loggerhead-instruments/HS1-HS2/Altium/PCBWAY_BOM/LS1-LS2-v3_bom.xlsx

Comment | Description | DigiKey | Designator | Footprint | Quantity | Notes
10uF | TCP0J106M8R | https://www.digikey.com/en/products/detail/rohm-semiconductor/TCP0J106M8R/923644 | C1, C3, C8, C13, C19 | Tant0805 | 5
0.1uF | Ceramic Chip Capacitor - X7R, 10% |  | C2, C5, C7, C9, C12, C14, C16, C18, C20 | 0402 | 9
1uF | Ceramic Chip Capacitor - X7R, 1% |  | C4, C10, C15, C21, C23, C24, C25, C26, C27, C28 | 0402 | 10
0.01uF | Ceramic Chip Capacitor - X7R, 10% |  | C6, C11, C17, C22 | 0402 | 4
switch | E-Switch EG1218 Slide Switch 200mA 30V | EG1903-ND | P2 | HDR1X3 | 1
C-GRID | 705530036 | WM4924-ND | P3 | HDR1X2 | 5
microSD Hirose | DM3D-SF | HR1941CT-ND | P4 | DM3D microSD | 1
pushbutton | FSM2JSMATR | 450-1757-2-ND | P13, P14, P15 | SOP4 | 3
C-GRID | 705530037 | WM4925-ND | P16, P17 | HDR1X3 | 2
CoinCellHolder | BU2032SM-BT-GTR |  | P24 | CoinCellHolder | 1
100k | ERJ-3EKF1003V 100k 1% 0603 |  | R1, R2 | 3-0603 | 2
10k | ERJ-3EKF1002V 10k 1% 0603 |  | R8, R9, R10 | 3-0603 | 3
4.7k | ERJ-3EKF4701V 1% 0603 |  | R4, R5 | 3-0603 | 2
TPS7A2033PDBVR | 300-mA, ultra-low-noise, low-IQ, low-dropout (LDO) linear regulator with high PSRR |  | U1 | MF05A_N (SOT-23) | 1
LP3985IM5-3.3 | Micropower, 150mA Low-Noise Ultra Low-Dropout CMOS Voltage Regulator | LP3985IM5-3.3/NOPBTR-ND | U2, U4, U5 | MF05A_N (SOT-23) | 3
SGTL5000 | SGTL5000XNAA3R2 | SGTL5000XNAA3R2CT-ND | U3 | QFN32 | 1
TLV70018DCKR | Single Output LDO, 200 mA, Fixed 1.8 V Output, 2 to 5.5 V Input, with Low IQ, 5-pin SC70 (DCK), -40 to 125 degC, Green (RoHS & no Sb/Br) | 296-32409-1-ND | U6 | TI-DCK5_V | 1
DS3231 | DS3231 Real-time clock | https://www.digikey.com/en/products/detail/maxim-integrated/DS3231S-T-R/1197575 | U10 | DS3231 | 1
Do not place the following
T495X227K010ATE050 | Solid Tantalum Chip Capacitor, Standard T495 Series - Low ESR, Surge Robust |  | C29 | X | 1 | Do not place
MJ1-3510-SMT | 3.5 mm, Mono, Right Angle, Surface Mount (SMT), Audio Jack Connector |  | J1 | CUI_MJ1-3510-SMT | 1 | Do not place
empty | Precision Thick Film Chip Resistor, 10 Ohm to 1M Ohm Range, 1% and 0.5% Tolerance, 0603 Size, 0.063 W |  | R3 | 3-0603 | 1 | Do not place
HYDROPHONE_MON | Header, 3-Pin |  | P26 | HDR1X3 | 1 | Do not place
