loggerhead-instruments/HS1-HS2/Altium/PCBWAY_BOM/T-U179W20819A-W20819AXU178-100sets-LS1-LS2-v3_bom  2021-6-3 - cost .xlsx

Comment | Description | DigiKey | Designator | Footprint | Quantity | Notes | 100sets |  | NOTE
10uF | Tantalum Capacitor, 20%, 6.3V or better |  | C1, C3, C8, C13, C19 | Tant0805 | 5 |  | $0.330 | $165.000 | TCP0J106M8R 7-10WORK DAYS
0.1uF | Ceramic Chip Capacitor - X7R, 10% |  | C2, C5, C7, C9, C12, C14, C16, C18, C20 | 0402 | 9 |  | $0.011 | $9.900 | 0.1UF 50V 0402
1uF | Ceramic Chip Capacitor - X7R, 1% |  | C4, C10, C15, C21, C23, C24, C25, C26, C27, C28 | 0402 | 10 |  | $0.011 | $11.000 | 1uf 25V 10% 0402, no 1%
0.01uF | Ceramic Chip Capacitor - X7R, 10% |  | C6, C11, C17, C22 | 0402 | 4 |  | $0.009 | $3.520 | 0.01UF 50V 0402
switch | E-Switch EG1218 Slide Switch 200mA 30V | EG1903-ND | P2 | HDR1X3 | 1 |  | $0.770 | $77.000 | EG1218
C-GRID | 705530036 | WM4924-ND | P3 | HDR1X2 | 1 |  | $0.902 | $90.200 | 7-10work days, is quantity 1? | Yes, quantity 1
microSD Hirose | DM3D-SF | HR1941CT-ND | P4 | DM3D microSD | 1 |  | $0.825 | $82.500
pushbutton | FSM2JSMATR | 450-1757-2-ND | P13, P14, P15 | SOP4 | 3 |  | $0.462 | $138.600 | 2-3 weeks
C-GRID | 705530037 | WM4925-ND | P16, P17 | HDR1X3 | 2 |  | $1.210 | $242.000 | 7-10work days
CoinCellHolder | BU2032SM-BT-GTR |  | P24 | CoinCellHolder | 1 |  | $1.641 | $164.100 | 6-8work days
100k | ERJ-3EKF1003V 100k 1% 0603 |  | R1, R2 | 3-0603 | 2 |  | $0.009 | $1.760
10k | ERJ-3EKF1002V 10k 1% 0603 |  | R8, R9, R10 | 3-0603 | 3 |  | $0.009 | $2.640
4.7k | ERJ-3EKF4701V 1% 0603 |  | R4, R5 | 3-0603 | 2 |  | $0.009 | $1.760
TPS7A2033PDBVR | 300-mA, ultra-low-noise, low-IQ, low-dropout (LDO) linear regulator with high PSRR |  | U1 | MF05A_N (SOT-23) | 1 |  | $0.286 | $28.600 | TPS7A2009PDBVR 7-10WORK DAYS
LP3985IM5-3.3 | Micropower, 150mA Low-Noise Ultra Low-Dropout CMOS Voltage Regulator | LP3985IM5-3.3/NOPBTR-ND | U2, U4, U5 | MF05A_N (SOT-23) | 3 |  | $0.385 | $115.500
SGTL5000 | SGTL5000XNAA3R2 | SGTL5000XNAA3R2CT-ND | U3 | QFN32 | 1 |  | $5.181 | $518.100 | SGTL5000XNAA3R2 7-10work days
TLV70018DCKR | Single Output LDO, 200 mA, Fixed 1.8 V Output, 2 to 5.5 V Input, with Low IQ, 5-pin SC70 (DCK), -40 to 125 degC, Green (RoHS & no Sb/Br) | 296-32409-1-ND | U6 | TI-DCK5_V | 1 |  | $0.550 | $55.000
DS3231 | Real-time clock |  | U10 | DS3231 | 1 |  | $7.810 | $781.000 | DS3231S#T&R 7-10work days
Do not place the following
T495X227K010ATE050 | Solid Tantalum Chip Capacitor, Standard T495 Series - Low ESR, Surge Robust |  | C29 | X | 1 | Do not place |  |  | Do not place
MJ1-3510-SMT | 3.5 mm, Mono, Right Angle, Surface Mount (SMT), Audio Jack Connector |  | J1 | CUI_MJ1-3510-SMT | 1 | Do not place |  |  | Do not place
empty | Precision Thick Film Chip Resistor, 10 Ohm to 1M Ohm Range, 1% and 0.5% Tolerance, 0603 Size, 0.063 W |  | R3 | 3-0603 | 1 | Do not place |  |  | Do not place
HYDROPHONE_MON | Header, 3-Pin |  | P26 | HDR1X3 | 1 | Do not place |  |  | Do not place
 |  |  |  |  |  |  |  | $2488.180
 |  |  |  |  |  |  | Per Description
