loggerhead-instruments/HS1-HS2/Altium/LS1_version3.pdf

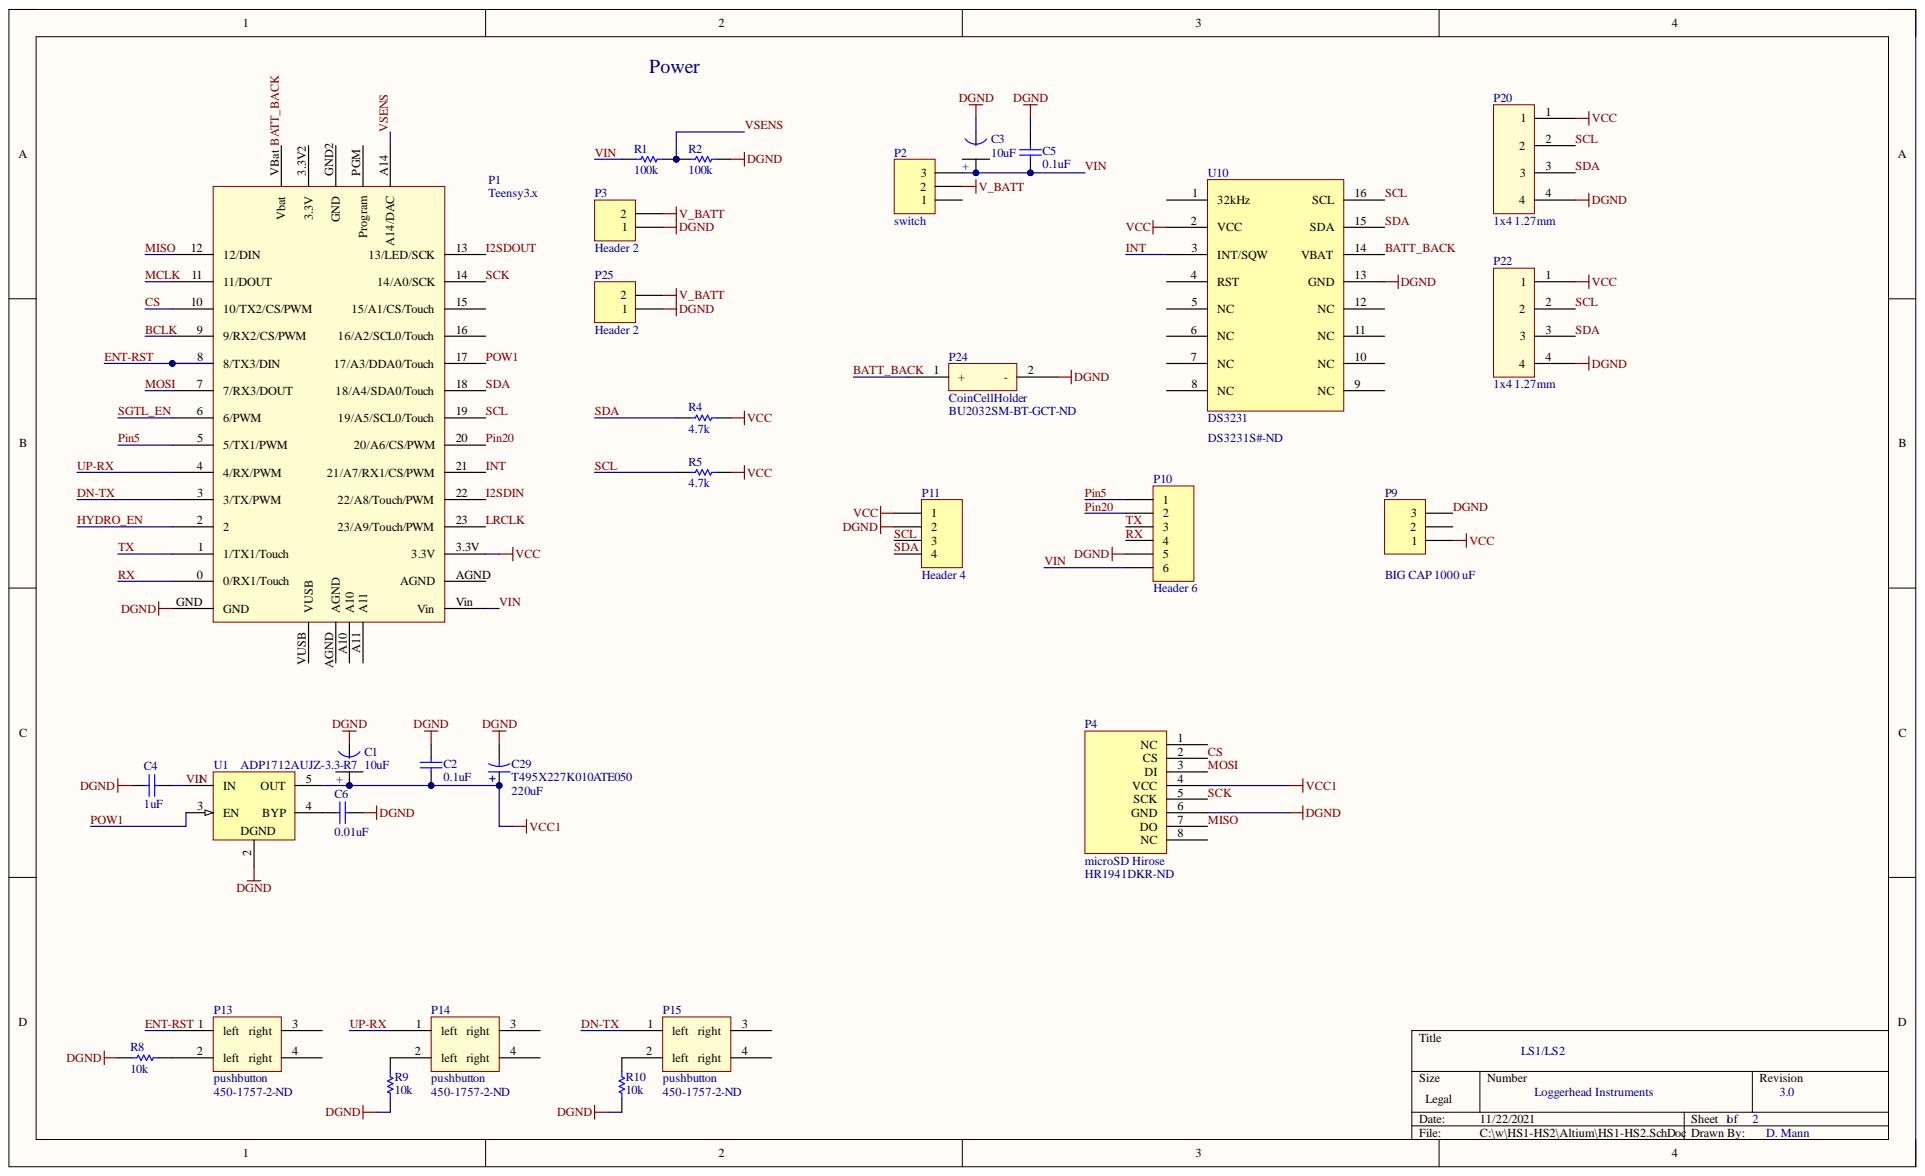
[picture p4: page 1]

Date: 11/22/2021 | Sheet of 1 2
File: C:\w\HS1-HS2\Altium\HS1-HS2.SchDoc | Drawn By: D. Mann

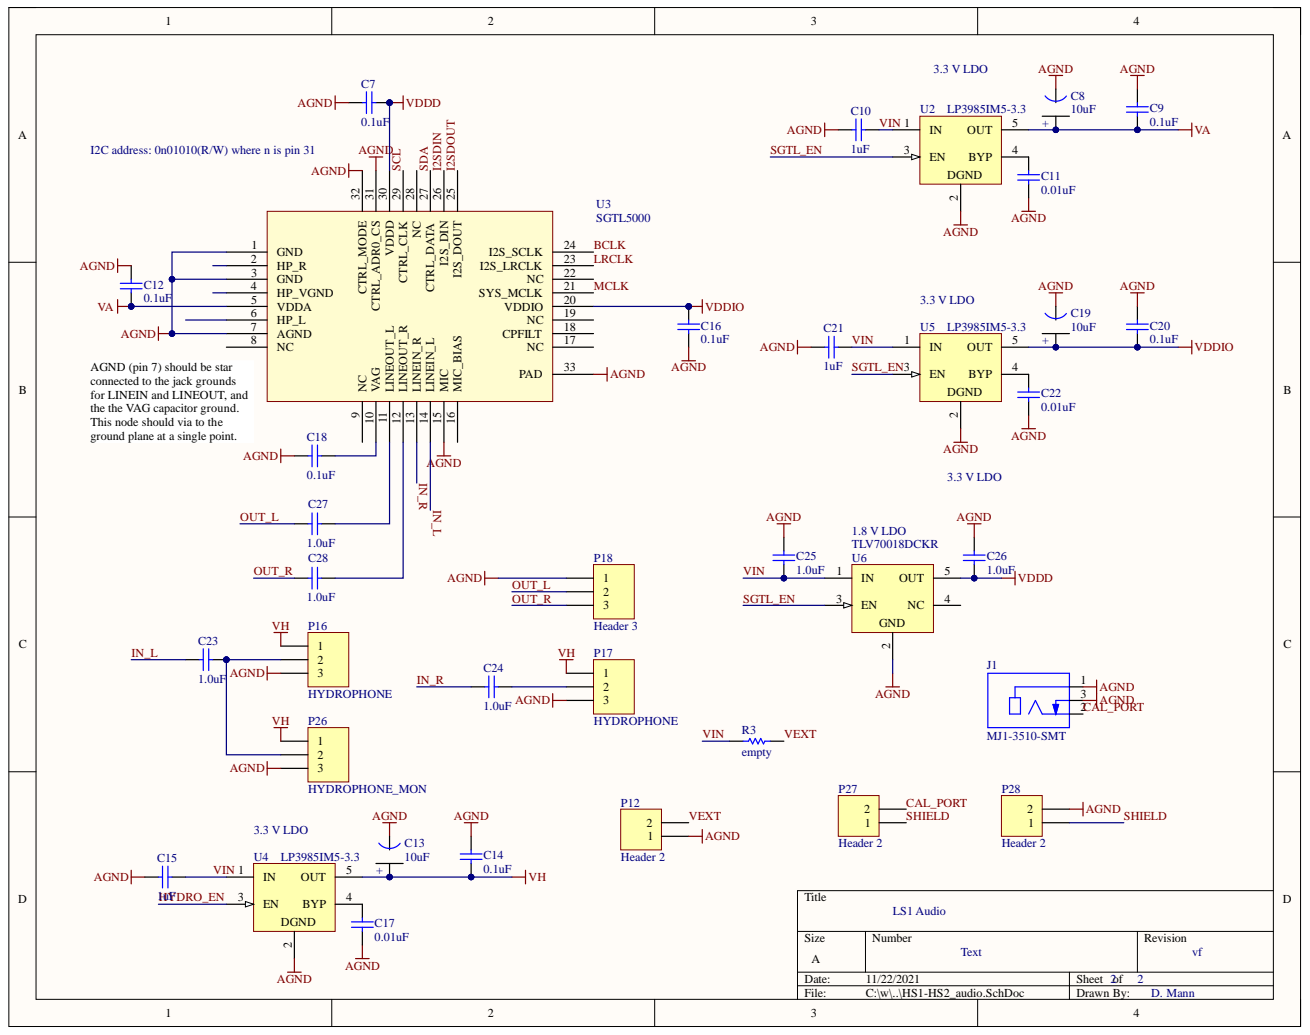
[picture p5: page 2]

AGND (pin 7) should be star
connected to the jack grounds
for LINEIN and LINEOUT, and
the the VAG capacitor ground.
This node should via to the
ground plane at a single point.
