loggerhead-instruments/HS1-HS2/(list of files, drawings)

Other design files:
Altium/HS1-HS2.PcbDoc
Altium/HS1-HS2.PrjPCB
Altium/HS1-HS2.SchDoc
Altium/HS1-HS2_audio.SchDoc
