loggerhead-instruments/HS1-HS2/Arduino/HS1-HS2/HS1-HS2.ino

//
// HS1 and HS2 Acoustic Recorders
//
// Loggerhead Instruments
// 2021
// David Mann 

// To do:
// - test power down card during sleep
// - 1 week test 1 minute on 4 minutes off

// 
// Modified from PJRC audio code
// http://www.pjrc.com/store/teensy3_audio.html
//
// Compile with 96 MHz Fastest

// Modified by WMXZ 15-05-2018 for SdFS and multiple sampling frequencies

//*****************************************************************************************

char codeVersion[5] = "3.00";
static boolean printDiags = 0;  // 1: serial print diagnostics; 0: no diagnostics
#define MQ 100 // to be used with LHI record queue (modified local version)
int roundSeconds = 60;//start time modulo to nearest roundSeconds
int wakeahead = 4;  //wake from snooze to give hydrophone to power up
int noDC = 0; // 0 = freezeDC offset; 1 = remove DC offset; 2 = bypass
int NCHAN = 2;
//*****************************************************************************************


#include "LHI_record_queue.h"
#include "control_sgtl5000.h"
#include <Audio.h>  //this also includes SD.h from lines 89 & 90
#include <Wire.h>
#include <SPI.h>
#include "SdFat.h"
#include <Snooze.h>  //using https://github.com/duff2013/Snooze; uncomment line 62 #define USE_HIBERNATE
#include <TimeLib.h>
#include <Adafruit_GFX.h>
#include <Adafruit_SSD1306.h>
#include <EEPROM.h>

#define CPU_RESTART_ADDR (uint32_t *)0xE000ED0C
#define CPU_RESTART_VAL 0x5FA0004
#define CPU_RESTART (*CPU_RESTART_ADDR = CPU_RESTART_VAL);

#define OLED_RESET -1
Adafruit_SSD1306 display(OLED_RESET);
#define BOTTOM 55

// set this to the hardware serial port you wish to use
#define HWSERIAL Serial1

#define NREC 32 // increase disk buffer to speed up disk access

static uint32_t myID[2];

unsigned long baud = 115200;

#define SECONDS_IN_MINUTE 60
#define SECONDS_IN_HOUR 3600
#define SECONDS_IN_DAY 86400
#define SECONDS_IN_YEAR 31536000
#define SECONDS_IN_LEAP 31622400

#define MODE_NORMAL 0
#define MODE_DIEL 1

// GUItool: begin automatically generated code
AudioInputI2S            i2s2;           //xy=105,63
LHIRecordQueue           queue1;         //xy=281,63
LHIRecordQueue           queue2;         //xy=281,63
AudioConnection          patchCord1(i2s2, 0, queue1, 0);
AudioConnection          patchCord2(i2s2, 1, queue2, 0);
AudioControlSGTL5000     sgtl5000_1;     //xy=265,212
// GUItool: end automatically generated code

const int myInput = AUDIO_INPUT_LINEIN;
int gainSetting = 4; //default gain setting; can be overridden in setup file


// Pin Assignments
const int UP = 4;
const int DOWN = 3;
const int SELECT = 8;
const int hydroPowPin = 2;
const int vSense = A14; 
#define SGTL_EN 6

// microSD chip select pins
#define CS1 10
#define SDPOW1 17
#define SDPOW2 16
#define SDSWITCH 15
#define SDSWITCHEN 20
int chipSelect[2];
int sdPowSelect[2];
uint32_t freeMB[2];
uint32_t filesPerCard[2];
volatile int currentCard = 0;
boolean newCard = 0;

// Pins used by audio shield
// https://www.pjrc.com/store/teensy3_audio.html
// MEMCS 6
// MOSI 7
// BCLK 9
// SDCS 10
// MCLK 11
// MISO 12
// RX 13
// SCLK 14
// VOL 15
// SDA 18
// SCL 19
// TX 22
// LRCLK 23

// Remember which mode we're doing
int mode = 0;  // 0=stopped, 1=recording, 2=playing
time_t startTime;
time_t stopTime;
time_t t;

byte startHour, startMinute, endHour, endMinute; //used in Diel mode
long dielRecSeconds;

int32_t lhi_fsamps[9] = {8000, 16000, 32000, 44100, 48000, 96000, 200000, 250000, 300000};
#define I_SAMP 8   // 0 is 8 kHz; 1 is 16 kHz; 2 is 32 kHz; 3 is 44.1 kHz; 4 is 48 kHz; 5 is 96 kHz; 6 is 192 kHz

float audio_srate = lhi_fsamps[I_SAMP];
int isf = 4; // default to 48 kHz
float gainDb;
int recMode = MODE_NORMAL;
unsigned long rec_dur = 60;
unsigned long rec_int = 60;

int snooze_hour;
int snooze_minute;
int snooze_second;
int buf_count;
unsigned long nbufs_per_file;
boolean settingsChanged = 0;

unsigned long file_count;
char filename[100];
char dirname[20];
int folderMonth;

SnoozeAlarm alarm;
SnoozeAudio snooze_audio;
SnoozeBlock config_teensy32(snooze_audio, alarm);

// SD_FAT_TYPE = 0 for SdFat/File as defined in SdFatConfig.h,
// 1 for FAT16/FAT32, 2 for exFAT, 3 for FAT16/FAT32 and exFAT.
#define SD_FAT_TYPE 3
const uint8_t SD_CS_PIN = 10;
#define SPI_CLOCK SD_SCK_MHZ(50)

// Try to select the best SD card configuration.
#if HAS_SDIO_CLASS
#define SD_CONFIG SdioConfig(FIFO_SDIO)
#elif ENABLE_DEDICATED_SPI
#define SD_CONFIG SdSpiConfig(SD_CS_PIN, DEDICATED_SPI, SPI_CLOCK)
#else  // HAS_SDIO_CLASS
#define SD_CONFIG SdSpiConfig(SD_CS_PIN, SHARED_SPI, SPI_CLOCK)
#endif  // HAS_SDIO_CLASS

// Set PRE_ALLOCATE true to pre-allocate file clusters.
const bool PRE_ALLOCATE = true;

// Set SKIP_FIRST_LATENCY true if the first read/write to the SD can
// be avoid by writing a file header or reading the first record.
const bool SKIP_FIRST_LATENCY = true;

#if SD_FAT_TYPE == 0
SdFat sd;
File file;
#elif SD_FAT_TYPE == 1
SdFat32 sd;
File32 file;
#elif SD_FAT_TYPE == 2
SdExFat sd;
ExFile file;
#elif SD_FAT_TYPE == 3
SdFs sd;
FsFile file;
#else  // SD_FAT_TYPE
#error Invalid SD_FAT_TYPE
#endif  // SD_FAT_TYPE

typedef struct {
    char    rId[4];
    unsigned int rLen;
    char    wId[4];
    char    fId[4];
    unsigned int    fLen;
    unsigned short nFormatTag;
    unsigned short nChannels;
    unsigned int nSamplesPerSec;
    unsigned int nAvgBytesPerSec;
    unsigned short nBlockAlign;
    unsigned short  nBitsPerSamples;
    char    dId[4];
    unsigned int    dLen;
} HdrStruct;

HdrStruct wav_hdr;

unsigned char prev_dtr = 0;

struct TIME_HEAD
{
  byte  sec;  
  byte  minute;  
  byte  hour;  
  byte  day;  
  byte  month;  
    byte NU[3];
  int16_t year;  
  int16_t tzOffset; //offset from GMT 
};

void setup() {
  read_myID();

  chipSelect[0] = CS1;
  chipSelect[1] = CS1;
  sdPowSelect[0] = SDPOW1;
  sdPowSelect[1] = SDPOW2;

  Serial.begin(baud);
  delay(500);

  RTC_CR = 0; // disable RTC
  delay(100);
  //Serial.println(RTC_CR,HEX);
  // change capacitance to 26 pF (12.5 pF load capacitance)
  RTC_CR = RTC_CR_SC16P | RTC_CR_SC8P | RTC_CR_SC2P; 
  delay(100);
  RTC_CR = RTC_CR_SC16P | RTC_CR_SC8P | RTC_CR_SC2P | RTC_CR_OSCE;
  delay(100);

  Serial.println(RTC_TSR);
  delay(1000);
  Serial.println(RTC_TSR);
  delay(1000);
  Serial.println(RTC_TSR);
  
  Wire.begin();
  pinMode(vSense, INPUT);
  analogReference(DEFAULT);
  
  pinMode(hydroPowPin, OUTPUT);
  digitalWrite(hydroPowPin, HIGH);

  pinMode(SDPOW1, OUTPUT);
  pinMode(SDPOW2, OUTPUT);
  pinMode(SDSWITCH, OUTPUT);
  pinMode(SDSWITCHEN, OUTPUT);
  digitalWrite(SDPOW1, LOW); // start all cards switched off in case of reset
  digitalWrite(SDPOW2, LOW);
  digitalWrite(SDSWITCH, LOW);
  digitalWrite(SDSWITCHEN, HIGH); // Enabled when low

  pinMode(SGTL_EN, OUTPUT);
  digitalWrite(SGTL_EN, HIGH); // power audio codec on
  
  //setup display and controls
  pinMode(UP, INPUT_PULLUP);
  pinMode(DOWN, INPUT_PULLUP);
  pinMode(SELECT, INPUT_PULLUP);
  
  display.begin(SSD1306_SWITCHCAPVCC, 0x3C);  //initialize display
  delay(140);
  cDisplay();
  display.println("Loggerhead");
  display.display();
  
  // Audio connections require memory, and the record queue
  // uses this memory to buffer incoming audio.
  // initialize now to estimate DC offset during setup
  AudioMemory(MQ+10);
  
  audio_srate = lhi_fsamps[isf];
//WMXZ  audioIntervalSec = 256.0 / audio_srate; //buffer interval in seconds

  AudioInit(isf); // load current gain setting
  manualSettings();
  audio_srate = lhi_fsamps[isf];
  AudioInit(isf); // set with new settings

  cDisplay();

  if(rec_int >= 60) roundSeconds = 60;
  if(rec_int >= 300) roundSeconds = 300;
  
  t = getTeensy3Time(1);  // sync teensy rtc to DS3231
  startTime = t;
  startTime -= startTime % roundSeconds;  
  startTime += roundSeconds; //move forward
  stopTime = startTime + rec_dur;  // this will be set on start of recording

  if (recMode==MODE_DIEL) setDielTime();  // adjust start time to diel mode
  
  nbufs_per_file = (long) (ceil(((rec_dur * audio_srate / 256.0) / (float) NREC)) * (float) NREC) * NCHAN;
  long ss = rec_int - wakeahead;
  if (ss<0) ss=0;
  snooze_hour = floor(ss/3600);
  ss -= snooze_hour * 3600;
  snooze_minute = floor(ss/60);
  ss -= snooze_minute * 60;
  snooze_second = ss;
  Serial.print("Snooze HH MM SS ");
  Serial.print(snooze_hour); Serial.print(":");
  Serial.print(snooze_minute); Serial.print(":");
  Serial.println(snooze_second);

  Serial.print("rec dur ");
  Serial.println(rec_dur);
  Serial.print("rec int ");
  Serial.println(rec_int);
  Serial.print("Current Time: ");
  printTime(t);
  Serial.print("Start Time: ");
  printTime(startTime);
  
  // Sleep here if won't start for 60 s
  long time_to_first_rec = startTime - t;
  Serial.print("Time to first record ");
  Serial.println(time_to_first_rec);
  
  mode = 0;

  // create first folder to hold data
  folderMonth = -1;  //set to -1 so when first file made will create directory
  checkSD();

  if(printDiags==0) {
    Serial.end();
  }
}

//
// MAIN LOOP
//

int recLoopCount;  //for debugging when does not start record
  
void loop() {
  // Standby mode
  if(mode == 0)
  {
      t = getTeensy3Time(0);
      cDisplay();
      display.println("Next Start");
      display.setTextSize(1);
      display.setCursor(0, 18);
      display.print("Card:");
      display.print(currentCard + 1);
      display.print(" ");
      display.print(filesPerCard[currentCard]);
      displayClock(startTime, 40);
      displayClock(t, BOTTOM);
      display.display();

      if(t >= startTime){      // time to start?
        if(noDC==0) {
          audio_freeze_adc_hp(); // this will lower the DC offset voltage, and reduce noise
        }
        if(noDC==2){
          audio_bypass_adc_hp();
         }
        if(printDiags) Serial.println("Record Start.");

        // set current stop time and calculate next startTime
        if(recMode==MODE_NORMAL){
          stopTime = startTime + rec_dur;
          startTime = stopTime + rec_int;
        }
        
        if(recMode==MODE_DIEL){
          if (rec_int==0){
             stopTime = startTime + dielRecSeconds;
             startTime = startTime + (24*3600); // increment startTime by 1 day
             if(printDiags) {
              Serial.print("New diel stop:");
              printTime(stopTime);
             }
             
          }
          else{
            stopTime = startTime + rec_dur;
            startTime = stopTime + rec_int;
            setDielTime(); // make sure new start is in diel window
          }
        }
        if(printDiags) {
          Serial.print("Current Time: ");
          printTime(getTeensy3Time(0));
          Serial.print("Stop Time: ");
          printTime(stopTime);
          Serial.print("Next Start:");
          printTime(startTime);
        }
        
        mode = 1;
        display.ssd1306_command(SSD1306_DISPLAYOFF); // turn off display during recording
        startRecording();
      }
  }


  // Record mode
  if (mode == 1) {
    continueRecording();  // download data  

    if(digitalRead(UP)==0 & digitalRead(DOWN)==0){
      // stop recording
      queue1.end();
      queue2.end();
      // update wav file header
      wav_hdr.rLen = 36 + buf_count * 256 * 2;
      wav_hdr.dLen = buf_count * 256 * 2;
      file.seek(0);
      file.write((uint8_t *)&wav_hdr, 44);
      file.close();

      display.begin(SSD1306_SWITCHCAPVCC, 0x3C);  //initialize display
      delay(100);
      cDisplay();
      display.println("Stopped");
      display.setTextSize(1);
      display.println("Safe to turn off");
      display.display();
      while(1);
    }
    
    if(buf_count >= nbufs_per_file){       // time to stop?
      if(((rec_int == 0) & (recMode==MODE_NORMAL)) | ((rec_int == 0) & (recMode==MODE_DIEL) & (getTeensy3Time(0)<stopTime))){
        file.close();
        checkSD();
        FileInit();  // make a new file
        buf_count = 0;
        if(printDiags) {
          Serial.print("Audio Mem: ");
          Serial.println(AudioMemoryUsageMax());
        }
      }
      else{
        stopRecording();
        checkSD();
        long ss = startTime - getTeensy3Time(0) - wakeahead;
        if (ss<0) ss=0;
        snooze_hour = floor(ss/3600);
        ss -= snooze_hour * 3600;
        snooze_minute = floor(ss/60);
        ss -= snooze_minute * 60;
        snooze_second = ss;
        
        if( (snooze_hour * 3600) + (snooze_minute * 60) + snooze_second >=20){
            digitalWrite(hydroPowPin, LOW); //hydrophone off
            I2S0_RCSR &= ~(I2S_RCSR_RE | I2S_RCSR_BCE); // de-select audio
            digitalWrite(SGTL_EN, LOW); // disable audio chip
            sd.end();
            digitalWrite(SDSWITCHEN, HIGH); // Disconnect SD cards; Enabled when low
            digitalWrite(SDPOW1, LOW); // turn off SD card
            digitalWrite(SDPOW2, LOW);
            
            if(printDiags){
              Serial.print("Snooze HH MM SS ");
              Serial.print(snooze_hour);
              Serial.print(snooze_minute);
              Serial.println(snooze_second);
              Serial.flush(); // make sure empty so doesn't prematurely wake
            }           
            delay(100);

            alarm.setRtcTimer(snooze_hour, snooze_minute, snooze_second); // to be compatible with new snooze library
            Snooze.sleep(config_teensy32); 

            /// ... Sleeping ....
            
            // Waking up
             if (printDiags) {
                Serial.begin(baud);
             }
             digitalWrite(SGTL_EN, HIGH);
             digitalWrite(SDSWITCHEN, LOW); // Enabled when low
             digitalWrite(sdPowSelect[currentCard], HIGH);  // power on current SD card
             digitalWrite(hydroPowPin, HIGH); // hydrophone on
             
             delay(300);
             
             // Initialize the SD card
             SPI.setMOSI(7);
             SPI.setSCK(14);
             SPI.setMISO(12);
             
             int cardFailCounter = 0;
             while(!sd.begin(CS1)){
              display.print("Card Fail");
              display.display();
              
              digitalWrite(sdPowSelect[currentCard], LOW); // turn off SD card
              digitalWrite(SDSWITCHEN, HIGH); // Disconnect SD cards; Enabled when low
              delay(700 + (1000 * cardFailCounter));
              digitalWrite(SDSWITCHEN, LOW);
              digitalWrite(sdPowSelect[currentCard], HIGH); // turn on SD card
              
              delay(300  + (1000 * cardFailCounter)); 
              if(cardFailCounter > 5) resetFunc();
              cardFailCounter++;
            }
            AudioInit(isf);
         }
        display.begin(SSD1306_SWITCHCAPVCC, 0x3C);  //initialize display
        mode = 0;  // standby mode
      }
    }
  }
  asm("wfi"); // reduce power between interrupts
}

void startRecording() {
  if (printDiags)  Serial.println("startRecording");
  FileInit();
  buf_count = 0;
  queue1.begin();
  if(NCHAN==2) queue2.begin();
  if (printDiags)  Serial.println("Queue Begin");
}


byte buffer[NREC*512];
void continueRecording() {
  if(NCHAN==1){
    if (queue1.available() >= NREC*2) {
      // Fetch 2 blocks (or multiples) from the audio library and copy
      // into a 512 byte buffer.  micro SD disk access
      // is most efficient when full (or multiple of) 512 byte sector size
      // writes are used.
      //digitalWrite(ledGreen, HIGH);
      for(int ii=0;ii<NREC;ii++)
      { byte *ptr = buffer+ii*512;
        memcpy(ptr, queue1.readBuffer(), 256);
        queue1.freeBuffer();
        memcpy(ptr+256, queue1.readBuffer(), 256);
        queue1.freeBuffer();
      }
      if(file.write(buffer, NREC*512)==-1) resetFunc(); //audio to .wav file
      buf_count += NREC;
    }
  }

  if(NCHAN==2){
    if (queue1.available() >= NREC) {
      // one buffer is 512 bytes = 256 samples
      // readBuffer returns an int16 * that contains 256 bytes
      for(int ii=0;ii<NREC;ii++){ 
        byte *ptr = buffer+(ii*512);
        mxLR(ptr, queue1.readBuffer(), queue2.readBuffer()); // interleave 256 points from each
        queue1.freeBuffer(); 
        queue2.freeBuffer();  // free buffer
      }
      if(file.write(buffer, NREC*512)==-1) resetFunc(); //audio to .wav file
      
      buf_count += NREC;
//      if(printDiags){
//        Serial.print(buf_count);
//        Serial.print(" ");
//        Serial.println((int16_t) buffer[1]<<8 | buffer[0]);
//      }
    }
  }

}

inline void mxLR(byte *dst, const int16_t *srcL, const int16_t *srcR){
    byte cnt = 128;
    int16_t *d = (int16_t *)dst;
    const int16_t *l = srcL;
    const int16_t *r = srcR;

    while (cnt--)
    {
      *(d++) = *l++;
      *(d++) = *r++;
    }
 }
  
void stopRecording() {
  if (printDiags) Serial.println("stopRecording");
  int maxblocks = AudioMemoryUsageMax();
  if (printDiags) Serial.print("Audio Memory Max");
  if (printDiags) Serial.println(maxblocks);
  byte buffer[512];
  queue1.end();
  if(NCHAN==2) queue2.end();
  AudioMemoryUsageMaxReset();
  file.close();
  delay(100);
}


void FileInit()
{
   t = getTeensy3Time(1); // this will also sync teensy clock used to wake up to DS3231

   // use folders for duty cycle record because short files could exceed max files per directory
   if (folderMonth != month(t) & (rec_int > 0)){
    if(printDiags) Serial.println("New Folder");
    folderMonth = month(t);
    sprintf(dirname, "/%04d-%02d", year(t), folderMonth);
    sd.mkdir(dirname);
   }
   pinMode(vSense, INPUT);  // get ready to read voltage
   float voltage = readVoltage();
   if (rec_int > 0) sd.chdir(dirname);

  #if USE_SDFS==1
    FsDateTime::callback = file_date_time;
  #else
    SdFile::dateTimeCallback(file_date_time);
  #endif

   // open file 
   sprintf(filename,"%04d%02d%02dT%02d%02d%02d_%lu%lu_%2.1fdB_%2.1fV_ver%s.wav", year(t), month(t), day(t), hour(t), minute(t), second(t), myID[0], myID[1], gainDb, voltage, codeVersion);  //filename is DDHHMMSS
   if(printDiags) Serial.println(filename);
   while (!file.open(filename, O_WRITE | O_CREAT | O_EXCL)){
    file_count += 1;
    sprintf(filename,"F%06d.wav",file_count); //if can't open just use count
    file.open(filename, O_WRITE | O_CREAT | O_EXCL);
    if(printDiags)Serial.println(filename);
    delay(10);
    if(file_count>20) {
      resetFunc();
      delay(1000);
    }
   }

    //intialize stereo .wav file header
    sprintf(wav_hdr.rId,"RIFF");
    wav_hdr.rLen=36;
    sprintf(wav_hdr.wId,"WAVE");
    sprintf(wav_hdr.fId,"fmt ");
    wav_hdr.fLen=0x10;
    wav_hdr.nFormatTag=1;
    wav_hdr.nChannels = NCHAN;
    wav_hdr.nSamplesPerSec=audio_srate;
    wav_hdr.nAvgBytesPerSec = audio_srate * 2 * NCHAN;
    wav_hdr.nBlockAlign = 2 * NCHAN;
    wav_hdr.nBitsPerSamples=16;
    sprintf(wav_hdr.dId,"data");
    wav_hdr.dLen = nbufs_per_file * 256 * 2;
    wav_hdr.rLen = 36 + wav_hdr.dLen;

    file.write((uint8_t *)&wav_hdr, 44);

    if(printDiags) Serial.print("Buffers: ");
    if(printDiags) Serial.println(nbufs_per_file);
}

//This function returns the date and time for SD card file access and modify time. One needs to call in setup() to register this callback function: SdFile::dateTimeCallback(file_date_time);
void file_date_time(uint16_t* date, uint16_t* time) 
{
  t = getTeensy3Time(1);
  #if USE_SDFS==1
    *date=FS_DATE(year(t),month(t),day(t));
    *time=FS_TIME(hour(t),minute(t),second(t));
  #else
    *date=FAT_DATE(year(t),month(t),day(t));
    *time=FAT_TIME(hour(t),minute(t),second(t));
  #endif
}

void AudioInit(int ifs){
 // Instead of using audio library enable; do custom so only power up what is needed in sgtl5000_LHI
  I2S_modification(lhi_fsamps[ifs], 16);
  Wire.begin();
  audio_enable(ifs);
}

void calcGain(){
    switch(gainSetting){
    case 0: gainDb = -20 * log10(3.12 / 2.0); break;
    case 1: gainDb = -20 * log10(2.63 / 2.0); break;
    case 2: gainDb = -20 * log10(2.22 / 2.0); break;
    case 3: gainDb = -20 * log10(1.87 / 2.0); break;
    case 4: gainDb = -20 * log10(1.58 / 2.0); break;
    case 5: gainDb = -20 * log10(1.33 / 2.0); break;
    case 6: gainDb = -20 * log10(1.11 / 2.0); break;
    case 7: gainDb = -20 * log10(0.94 / 2.0); break;
    case 8: gainDb = -20 * log10(0.79 / 2.0); break;
    case 9: gainDb = -20 * log10(0.67 / 2.0); break;
    case 10: gainDb = -20 * log10(0.56 / 2.0); break;
    case 11: gainDb = -20 * log10(0.48 / 2.0); break;
    case 12: gainDb = -20 * log10(0.40 / 2.0); break;
    case 13: gainDb = -20 * log10(0.34 / 2.0); break;
    case 14: gainDb = -20 * log10(0.29 / 2.0); break;
    case 15: gainDb = -20 * log10(0.24 / 2.0); break;
  }
}

time_t getTeensy3Time(boolean syncTeensy)
{
  if(readRTC()){
    if(syncTeensy) setTeensyTime(hour(t),minute(t),second(t),day(t),month(t),year(t)); // sync from DS3231 to Teensy time
    return t;
  }
  else{
    return Teensy3Clock.get();  // return Teensy internal clock
  }
  
}

void resetFunc(void){
  EEPROM.write(20, 1); // reset indicator register
  if(mode == 1) file.close();  // close file if open

  // disconnect cards
  digitalWrite(SDSWITCHEN, HIGH); // switch is enabled low
  digitalWrite(SDPOW2, LOW);
  digitalWrite(SDPOW1, LOW); 
  delay(1000);
  CPU_RESTART
}

void read_myID() {
//  myID[0] = SIM_UIDH;
  myID[0] = SIM_UIDMH;
  myID[1] = SIM_UIDML;
//  myID[3] = SIM_UIDL;
}


float readVoltage(){
   float  voltage = 0;
   for(int n = 0; n<8; n++){
    voltage += (float) analogRead(vSense) / 1024.0;
   }
   voltage = 7.27 * voltage / 8.0;   //fudging scaling based on actual measurements; shoud be max of 3.3V at 1023
   return voltage;
}

void checkSD(){
  if (filesPerCard[currentCard] > 0) filesPerCard[currentCard] -= 1;
  else{
    currentCard++;
    if(currentCard > 1){
      // disconnect cards
      digitalWrite(SDSWITCHEN, HIGH); // switch is enabled low
      digitalWrite(SDPOW2, LOW);
      digitalWrite(SDPOW1, LOW);  // turn off card 1
      while(1);
    }
    sd.end();
    digitalWrite(SDPOW2, HIGH);
    digitalWrite(SDSWITCH, HIGH); // LOW is Normally Closed, Card 1; HIGH Card 2
    digitalWrite(SDSWITCHEN, LOW); // switch is enabled low
    
    delay(100);
    if (filesPerCard[currentCard] > 0) filesPerCard[currentCard] -= 1;
    if(!sd.begin(CS1)){
      display.print("Card 2 Fail");
      display.display();
      delay(1000);
      resetFunc();
    }
    if(rec_int>0) {
      sd.mkdir(dirname);
      sd.chdir(dirname);
    }
    digitalWrite(SDPOW1, LOW);  // turn off card 1
    
  }

  if(printDiags){
    Serial.print("Files per card: ");
    Serial.println(filesPerCard[currentCard]);
  }
}

void setDielTime(){
  unsigned int startMinutes = (startHour * 60) + (startMinute);
  unsigned int endMinutes = (endHour * 60) + (endMinute );
  unsigned int startTimeMinutes =  (hour(startTime) * 60) + (minute(startTime));
  
  tmElements_t tmStart;
  tmStart.Year = year(startTime) - 1970;
  tmStart.Month = month(startTime);
  tmStart.Day = day(startTime);


  // check if next startTime is between startMinutes and endMinutes
  // e.g. 06:00 - 12:00 or 
  if(startMinutes<endMinutes){
     if ((startTimeMinutes < startMinutes) | (startTimeMinutes > endMinutes)){
       // set startTime to startHour startMinute
       tmStart.Hour = startHour;
       tmStart.Minute = startMinute;
       tmStart.Second = 0;
       startTime = makeTime(tmStart);
       if(startTime < getTeensy3Time(0)) startTime += SECS_PER_DAY;  // make sure after current time
       if(printDiags) {
        Serial.print("New diel start:");
        printTime(startTime);
       }
       
     }
     dielRecSeconds = (endMinutes-startMinutes) * 60;
     if(printDiags) Serial.print("Diel Rec Seconds");
     if(printDiags) Serial.println(dielRecSeconds);
  }
  else{  // e.g. 23:00 - 06:00
    if((startTimeMinutes<startMinutes) & (startTimeMinutes>endMinutes)){
      // set startTime to startHour:startMinute
       tmStart.Hour = startHour;
       tmStart.Minute = startMinute;
       tmStart.Second = 0;
       startTime = makeTime(tmStart);
       if(startTime < getTeensy3Time(0)) startTime += SECS_PER_DAY;  // make sure after current time
       if(printDiags){
        Serial.print("New diel start:");
        printTime(startTime);
       }
       
    }
    dielRecSeconds = ((1440 - startMinutes) * 60) + (endMinutes * 60);
    if(printDiags) Serial.print("Diel Rec Seconds");
    if(printDiags) Serial.println(dielRecSeconds);
  }
}
