loggerhead-instruments/HS1-HS2/(commit log)

2021-03-15 update project
    [HS1-HS2.PrjPCB]
2021-03-15 big cap
    [HS1-HS2.PcbDoc, HS1-HS2.SchDoc]
2021-03-24 add card switching chip
    [HS1-HS2.PcbDoc, HS1-HS2.PrjPCB, HS1-HS2.SchDoc]
2021-04-07 card switch and power audio codec
2021-04-07 power down audio chip and card while sleeping
2021-04-07 pick and place
    [Pick Place for HS1-HS2.csv]
2021-04-11 update sleep power
2021-04-11 power off cards during sleep
2021-04-12 handle fail to sd.begin on wake from sleep
    [HS1-HS2.ino, display.ino]
2021-04-12 sd switch must be enabled before card powered on
2021-06-02 single card
    [HS1-HS2.PcbDoc, HS1-HS2.SchDoc, HS1-HS2_audio.SchDoc]
2021-06-07 update GM1
    [HS1-HS2.PcbDoc, HS1-HS2.PrjPCB, HS1-HS2.SchDoc, HS1-HS2.xlsx, LS1-LS2-v3_bom.xlsx, Pick Place for HS1-HS2.csv, Pick Place for LS1-LS2.csv, T-U179W20819A-W20819AXU178-100sets-LS1-LS2-v3_bom 2021-6-3 - cost .xlsx]
2021-08-06 fix hydrophone power
    [HS1-HS2.PcbDoc, HS1-HS2.PrjPCB]
2022-12-21 add LED, Gerbers
    [HS1-HS2.GBL, HS1-HS2.GBO, HS1-HS2.GBP, HS1-HS2.GBS, HS1-HS2.GM1, HS1-HS2.GTL, HS1-HS2.GTO, HS1-HS2.GTP]
